opensx/Funkregler2/README.md

# Funkregler2
Funkregler Rev.2 für Selectrix mit WLAN (WiFi, MKR1000 basierend)

Ähnlich wie der XBee-Funkregler, nur dass er mit WLAN und dem Arduino MKR1000
arbeitet und im "Retro"-Design mit 7-Segment Anzeige für Selectrix optimiert ist.

Vorteile:
* einfacher zu konfigurieren
* kompakter (FRED Formfaktor)
* mit 7-Seg Anzeige

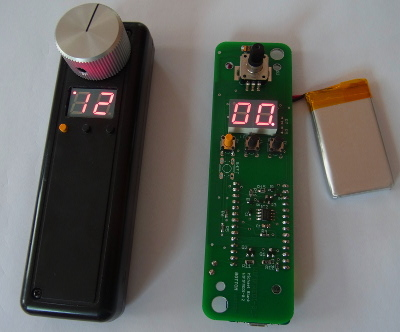
[picture p1: funkregler2-mit-ohne-gehaeuse_kl.jpg]
Funkregler2</img>

siehe auch <a href="http://opensx.net/funkregler2">Funkregler2 auf opensx.net</a>
