opensx/Funkregler2/hardware/README.md

# Funkregler2
Funkregler mit MKR1000 für Selectrix

mehr zur Hardware (Funkregler und Basisstation) siehe
<a href="http://opensx.net/funkregler2">
Funkregler2 auf opensx.net</a>

Funkregler2 - mit und ohne Gehäuser</img>
