opensx/Funkregler2/hardware/wififredi-0.3a.pdf

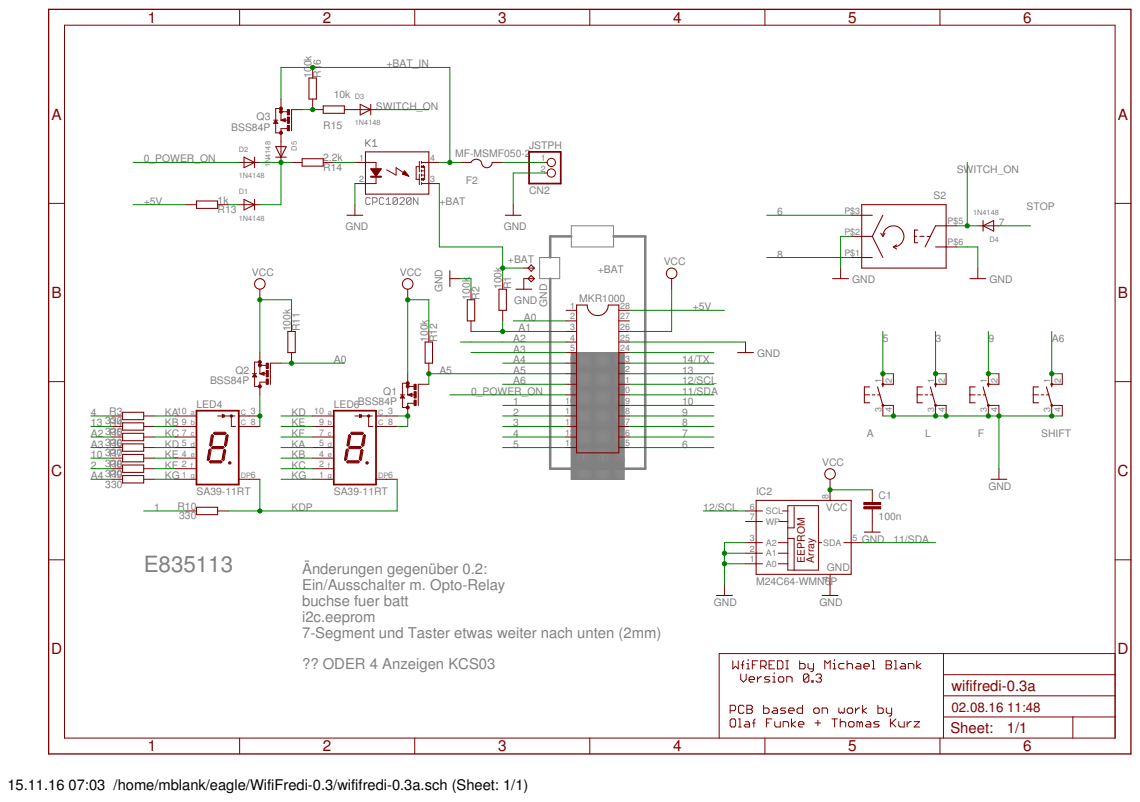
[picture p2: page 1]

Ein/Ausschalter m. Opto-Relay
buchse fuer batt
i2c.eeprom
7-Segment und Taster etwas weiter nach unten (2mm)
?? ODER 4 Anzeigen KCS03

15.11.16 07:03 /home/mblank/eagle/WifiFredi-0.3/wififredi-0.3a.sch (Sheet: 1/1)
