opensx/Funkregler2/hardware/wififredi-0.3a-pcb.pdf

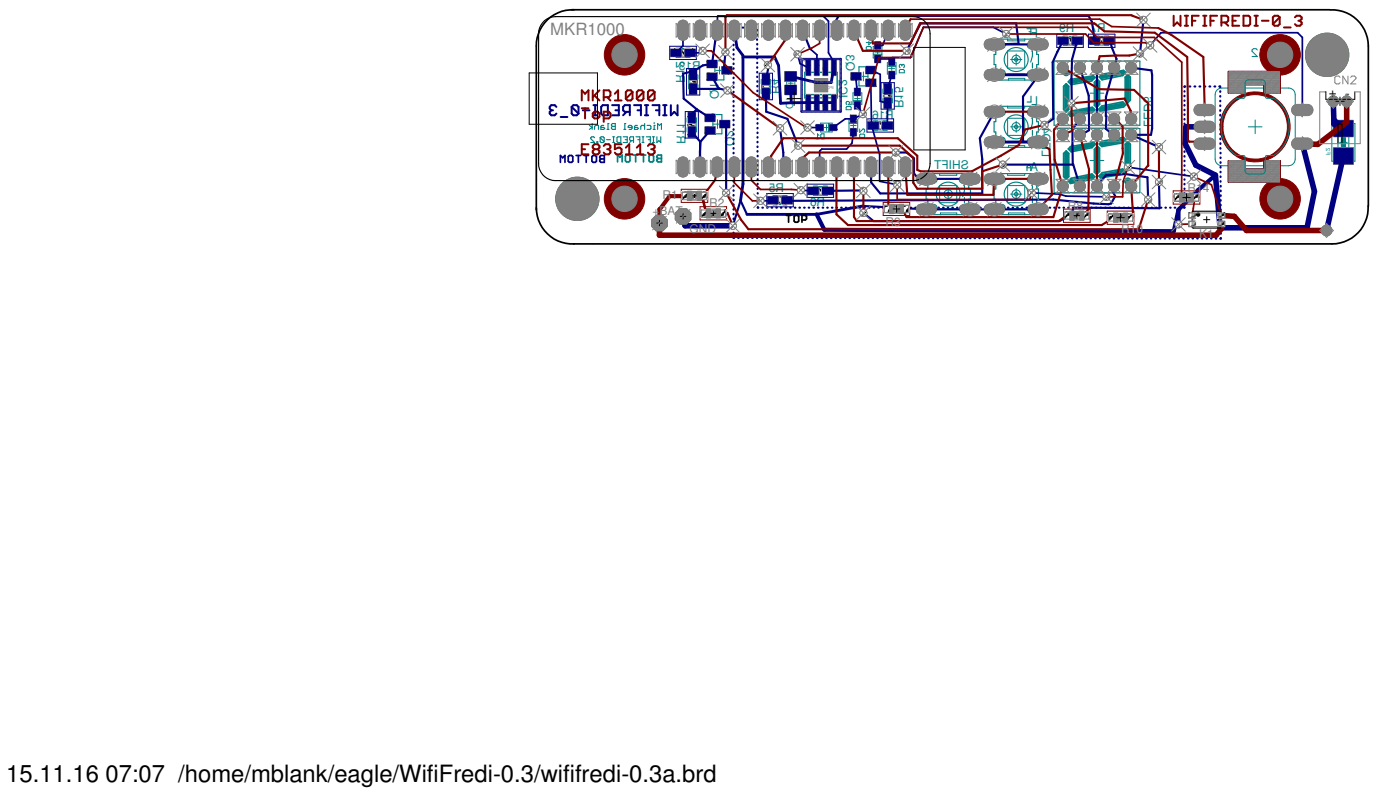
[picture p3: page 1]

15.11.16 07:07 /home/mblank/eagle/WifiFredi-0.3/wififredi-0.3a.brd
