opensx/Funkregler2/software/Funkregler2DCC/Display7.h

/*
 * Display7.h
 *
 * for a 2 digit 7-segment LED display (with mkr1000)
 * WiFi-Fredi 0.2 (with mkr1000)
 *
 *  Created on: 20.07.2016
 *      Author: mblank
 */

#ifndef DISPLAY7_H_
#define DISPLAY7_H_

#include <Arduino.h>
#include "pcb-type.h"

#define NCHAR   20
#define NSEG     8      // a   b   c  d   e  f  g  DP
#define DP_SEG   7
#define D_ON     1
#define D_OFF    0
#define BLINK    2      // set 2 for blinking (0=off, 1=on)

class Display7 {

public:
	Display7(void);
	void init(void);
	void switchOn(int disp);  // switch on 1 of the four digits
	void setDecPoint(int disp, bool on); // switch on/off decimal point left or right
	void decBlink(int disp);   // set the decimal point to blink
	void setPowerBlink(bool state);   //middle 2 dec.points
	void doDisplay(int digit);
	void switchOff();
	void dispChar(uint8_t d, char c);
	void blinkChar(uint8_t d, char c);

	void dispCharacters(char c1, char c2);
	void dispCharacters(char c1, char c2, uint32_t block);
  void blinkCharacters(char c1, char c2);
  
 #ifdef DIGITS4
	void dispCharacters(char c1, char c2, char c3, char c4);
	void dispCharacters(char c1, char c2, char c3, char c4, uint32_t block);
	void blinkCharacters(char c1, char c2, char c3, char c4);
 #endif
	void dispError(char c);   //  E'c' blinking
	void dispNumber(int n);   //0...199
	void dispNumberSigned(int n, bool back);
	void dispBlinkNumber(int n);
	void setDim(bool);bool isDimming();
	void setFlicker(bool);
	void test(void);

private:

	bool _flickerOn;
	bool _dim;
	uint32_t _blockTime;   // block display for some milliseconds

#ifdef DIGITS4
	volatile int _segmentOn[4][NSEG];  // [0 (leftmost),1,2,3][ a b .... DP]
#else
	volatile int _segmentOn[2][NSEG];  // [right/left][ a b .... DP]
#endif

};

#endif /* DISPLAY7_H_ */
