opensx/Funkregler2/(commit log)

2016-08-08 initial version of Arduino (MKR1000) SW
2016-08-08 corr. timeout in config routine, fixed AddrSel bug
    [AddrSelection.cpp, AddrSelection.h, FunkrEEPROM.cpp, Funkregler2.ino]
2016-08-12 first version with 4digit LED support
2016-11-15 pcb layout wififredi-0.3a hinzugefügt
2016-11-24 improved error handling when no wifi connection
    [FunkrEEPROM.h, Funkregler2.ino]
2017-08-03 added reset for wifi chip in case of rssi=0
    [Funkregler2DCC.ino]
2017-08-06 Stop-Button long press = toggle Layout Power
2017-08-08 blinking dec. points when power=off and other minor enhancemens
